Anubhav-Anand-7/Rain_Rain_Go_Away/84_rain_rain_go_away_Photos/Rain Sensor and IR Remote.jpg

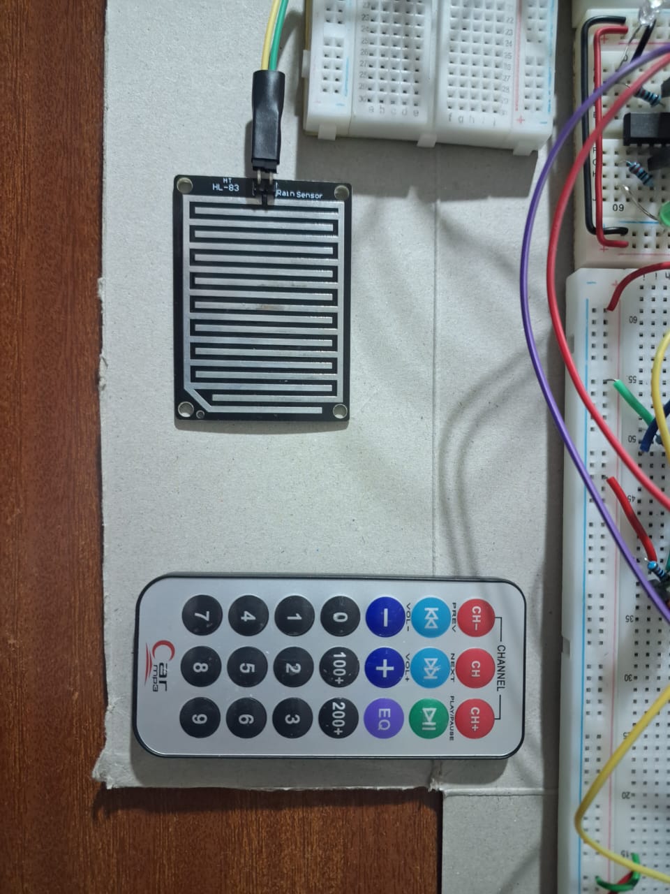
84_rain_rain_go_away_Photos/Rain Sensor and IR Remote.jpg
