Anubhav-Anand-7/Rain_Rain_Go_Away/84_rain_rain_go_away_Photos/Microcontroller Unit.jpg

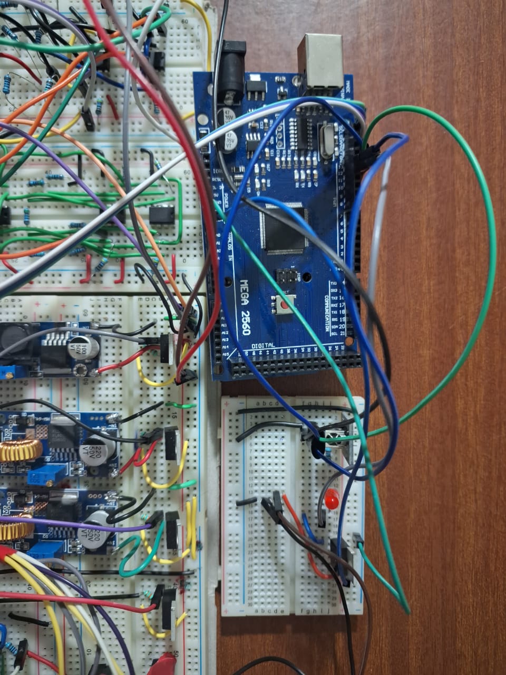
84_rain_rain_go_away_Photos/Microcontroller Unit.jpg
