Anubhav-Anand-7/Rain_Rain_Go_Away/84_rain_rain_go_away_Photos/Needle.jpg

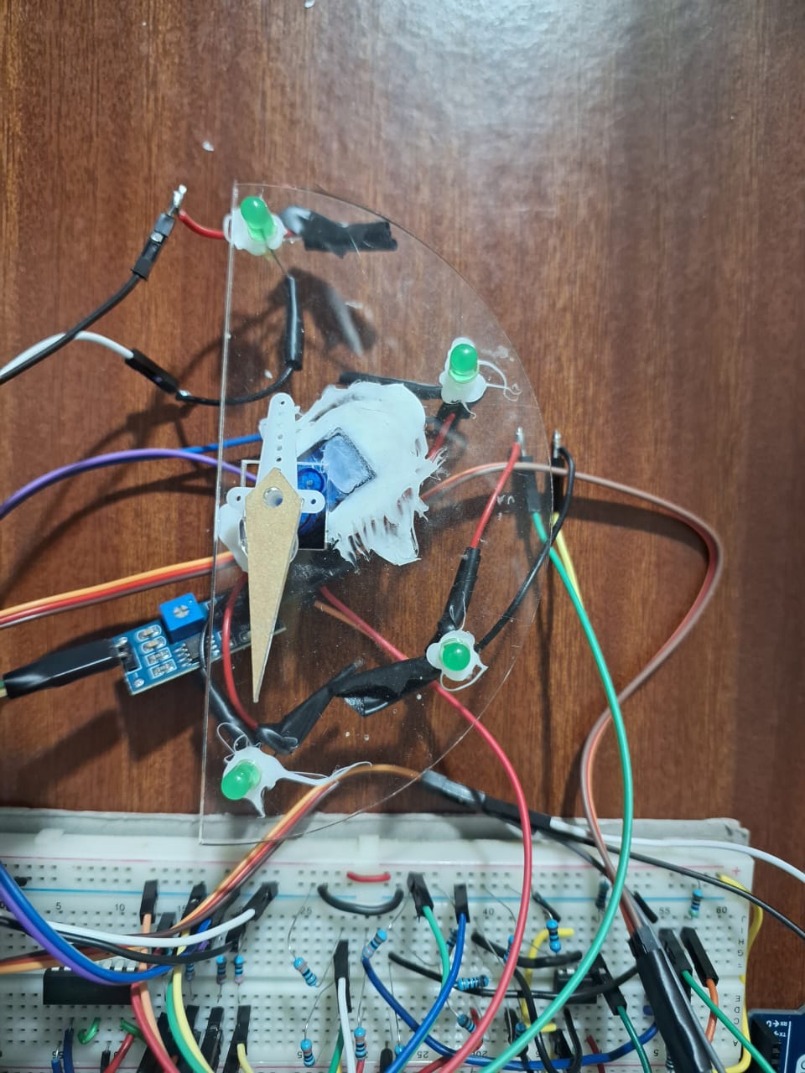
84_rain_rain_go_away_Photos/Needle.jpg
